src1138/VMFB-MC/motioneyeos_scripts/RPi_ZeroW_Pinout.png

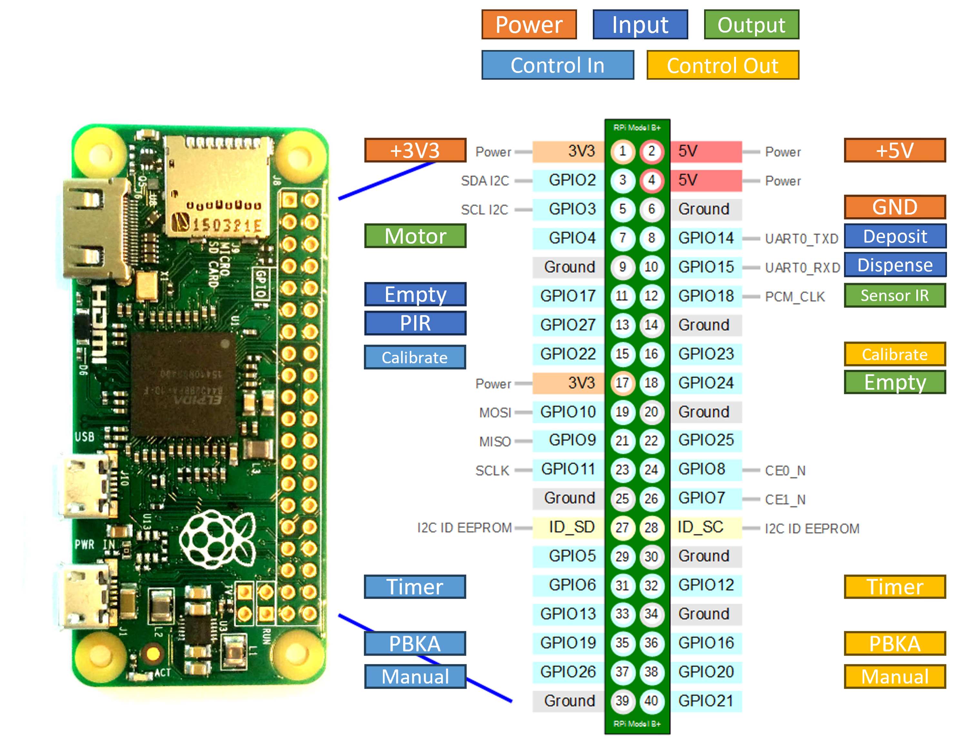
motioneyeos_scripts/RPi_ZeroW_Pinout.png
