src1138/VMFB-MC/README.md

# VMFB-MC
Simplified version of the VMFB (https://github.com/src1138/VMFB) PCB designed with a smaller footprint and BOM to rely on a microcontroller or single-board computer to control and monitor it.
