src1138/VMFB-MC/VMFB-MC.kicad_pcb

## KiCad design VMFB-MC.kicad_pcb (2025-01-15)

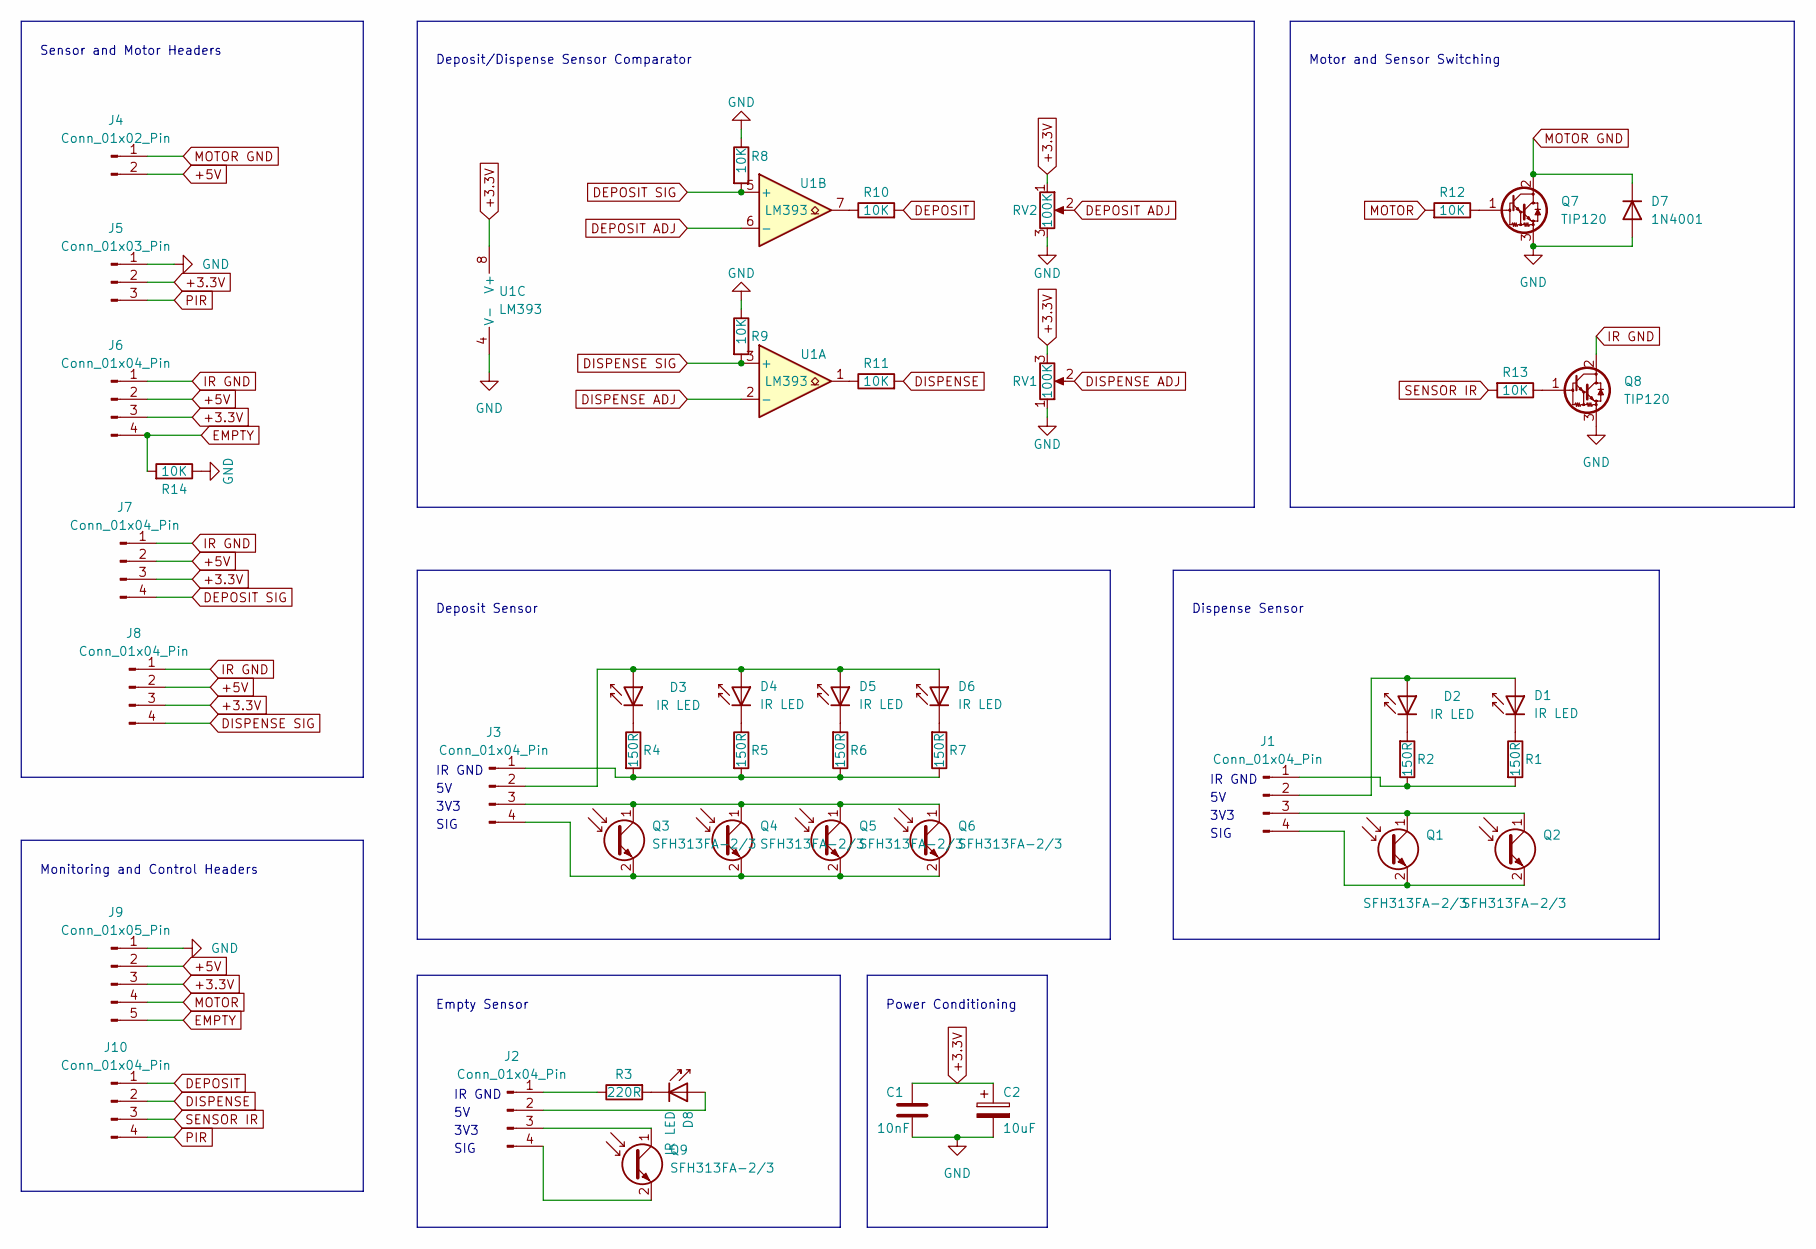
[picture p2: schematic VMFB-MC.kicad_sch, Vending Machine For Birds - Microcontroller Controlled]

Parts:
C1: 10nF; C_Disc_D5.0mm_W2.5mm_P2.50mm
C2: 10uF; CP_Radial_D5.0mm_P2.00mm
D1, D2, D3, D4, D5, D6, D8: IR LED; LED_D5.0mm_IRGrey
D7: 1N4001; D_DO-41_SOD81_P2.54mm_Vertical_KathodeUp
J1, J2, J3, J6, J7, J8, J10: Conn_01x04_Pin; PinHeader_1x04_P2.54mm_Vertical
J4: Conn_01x02_Pin; PinHeader_1x02_P2.54mm_Vertical
J5: Conn_01x03_Pin; PinHeader_1x03_P2.54mm_Vertical
J9: Conn_01x05_Pin; PinHeader_1x05_P2.54mm_Vertical
Q1, Q2, Q3, Q4, Q5, Q6, Q9: SFH313FA-2/3; LED_D5.0mm_IRBlack
Q7, Q8: TIP120; TO-220-3_Vertical
R1, R2, R4, R5, R6, R7: 150R; R_Axial_DIN0207_L6.3mm_D2.5mm_P2.54mm_Vertical
R3: 220R; R_Axial_DIN0207_L6.3mm_D2.5mm_P2.54mm_Vertical
R8, R9, R10, R11, R12, R13, R14: 10K; R_Axial_DIN0207_L6.3mm_D2.5mm_P2.54mm_Vertical
RV1, RV2: 100K; Potentiometer_Piher_PT-10-V10_Vertical
U1: LM393; DIP-8_W7.62mm

Connections:
+3.3V: C1.1, C2.1, J5.2, J6.3, J7.3, J8.3, J9.3, RV1.3, RV2.1, U1.8 (V+)
+5V: J4.2, J6.2, J7.2, J8.2, J9.2
DEPOSIT: J10.1, R10.2
DEPOSIT ADJ: RV2.2, U1.6 (-)
DEPOSIT SIG: J7.4, R8.2, U1.5 (+)
DISPENSE: J10.2, R11.2
DISPENSE ADJ: RV1.2, U1.2 (-)
DISPENSE SIG: J8.4, R9.2, U1.3 (+)
EMPTY: J6.4, J9.5, R14.2
GND: C1.2, C2.2, D7.2 (A), J5.1, J9.1, Q7.3 (E), Q8.3 (E), R8.1, R9.1, R14.1, RV1.1, RV2.3, U1.4 (V-)
IR GND: J6.1, J7.1, J8.1, Q8.2 (C)
MOTOR: J9.4, R12.2
MOTOR GND: D7.1 (K), J4.1, Q7.2 (C)
unnamed: D1.2 (A), D2.2 (A), J1.2
unnamed: D1.1 (K), R1.1
unnamed: D2.1 (K), R2.2
unnamed: D3.2 (A), D4.2 (A), D5.2 (A), D6.2 (A), J3.2
unnamed: D3.1 (K), R4.1
unnamed: D4.1 (K), R5.1
unnamed: D5.1 (K), R6.2
unnamed: D6.1 (K), R7.2
unnamed: D8.2 (A), J2.2
unnamed: D8.1 (K), R3.2
unnamed: J1.1, R1.2, R2.1
unnamed: J1.3, Q1.1 (C), Q2.1 (C)
unnamed: J1.4, Q1.2 (E), Q2.2 (E)
unnamed: J2.1, R3.1
unnamed: J2.3, Q9.1 (C)
unnamed: J2.4, Q9.2 (E)
unnamed: J3.1, R4.2, R5.2, R6.1, R7.1
unnamed: J3.3, Q3.1 (C), Q4.1 (C), Q5.1 (C), Q6.1 (C)
unnamed: J3.4, Q3.2 (E), Q4.2 (E), Q5.2 (E), Q6.2 (E)
unnamed: Q7.1 (B), R12.1
unnamed: Q8.1 (B), R13.1
unnamed: R10.1, U1.7
unnamed: R11.1, U1.1
PIR: J5.3, J10.4
SENSOR IR: J10.3, R13.2

Notes on the sheet:
Sensor and Motor Headers
IR GND
Monitoring and Control Headers
3V3
Motor and Sensor Switching
SIG
Deposit Sensor
Dispense Sensor
Empty Sensor
Power Conditioning
Deposit/Dispense Sensor Comparator

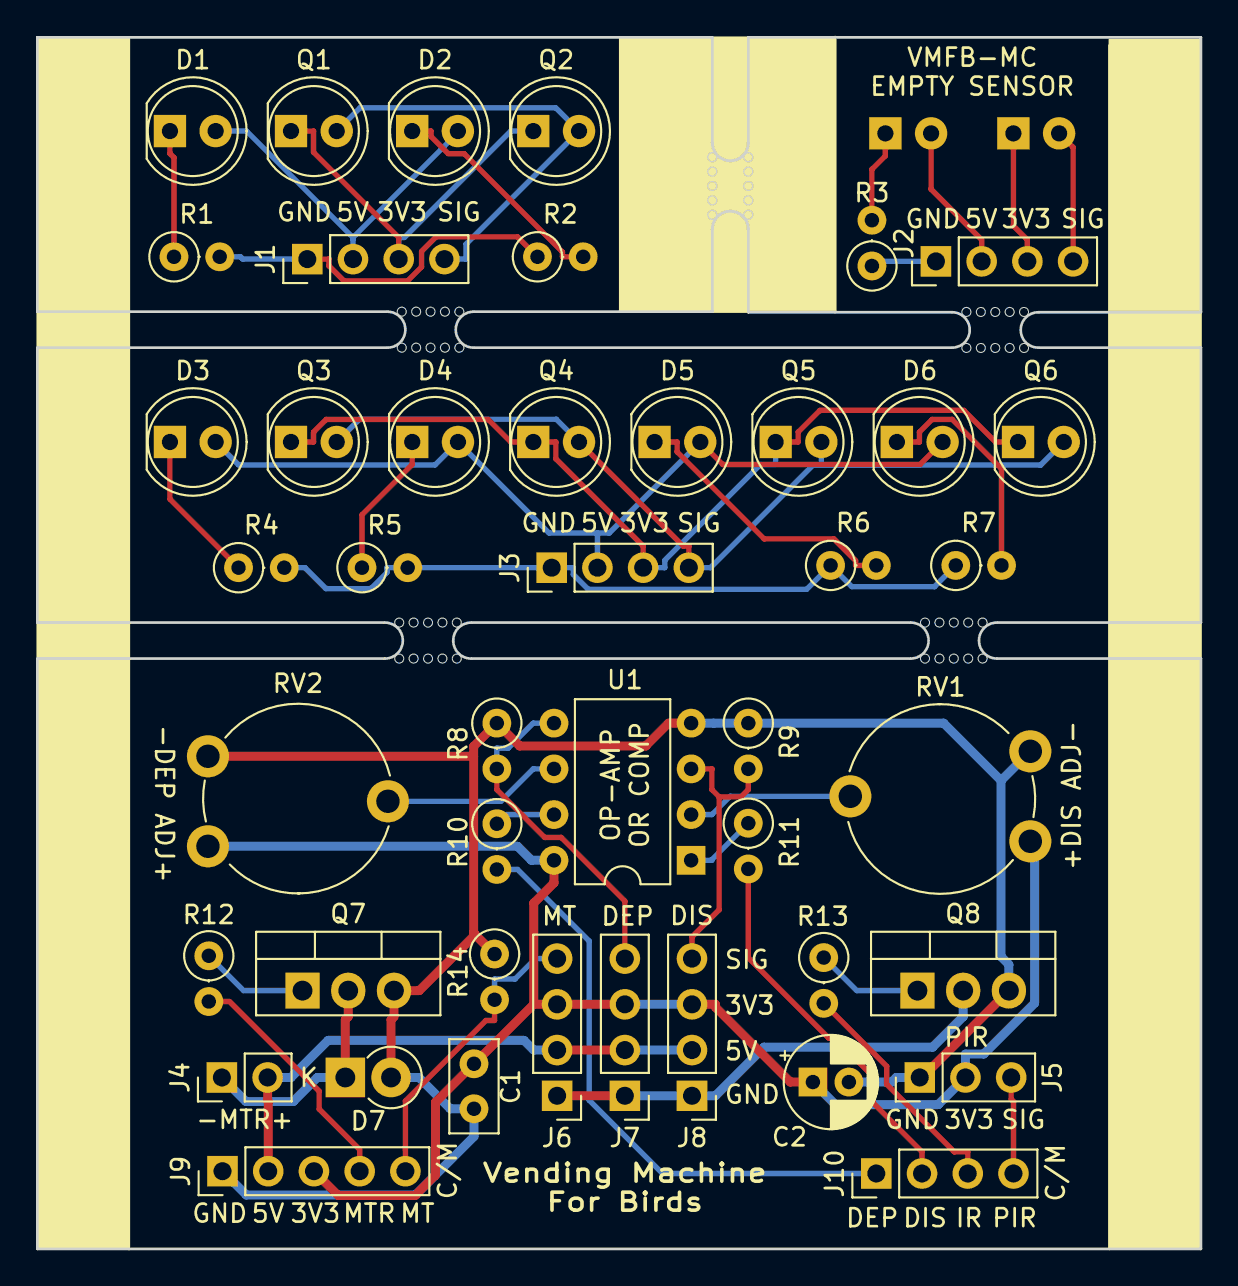
[picture p3: board VMFB-MC.kicad_pcb from above]

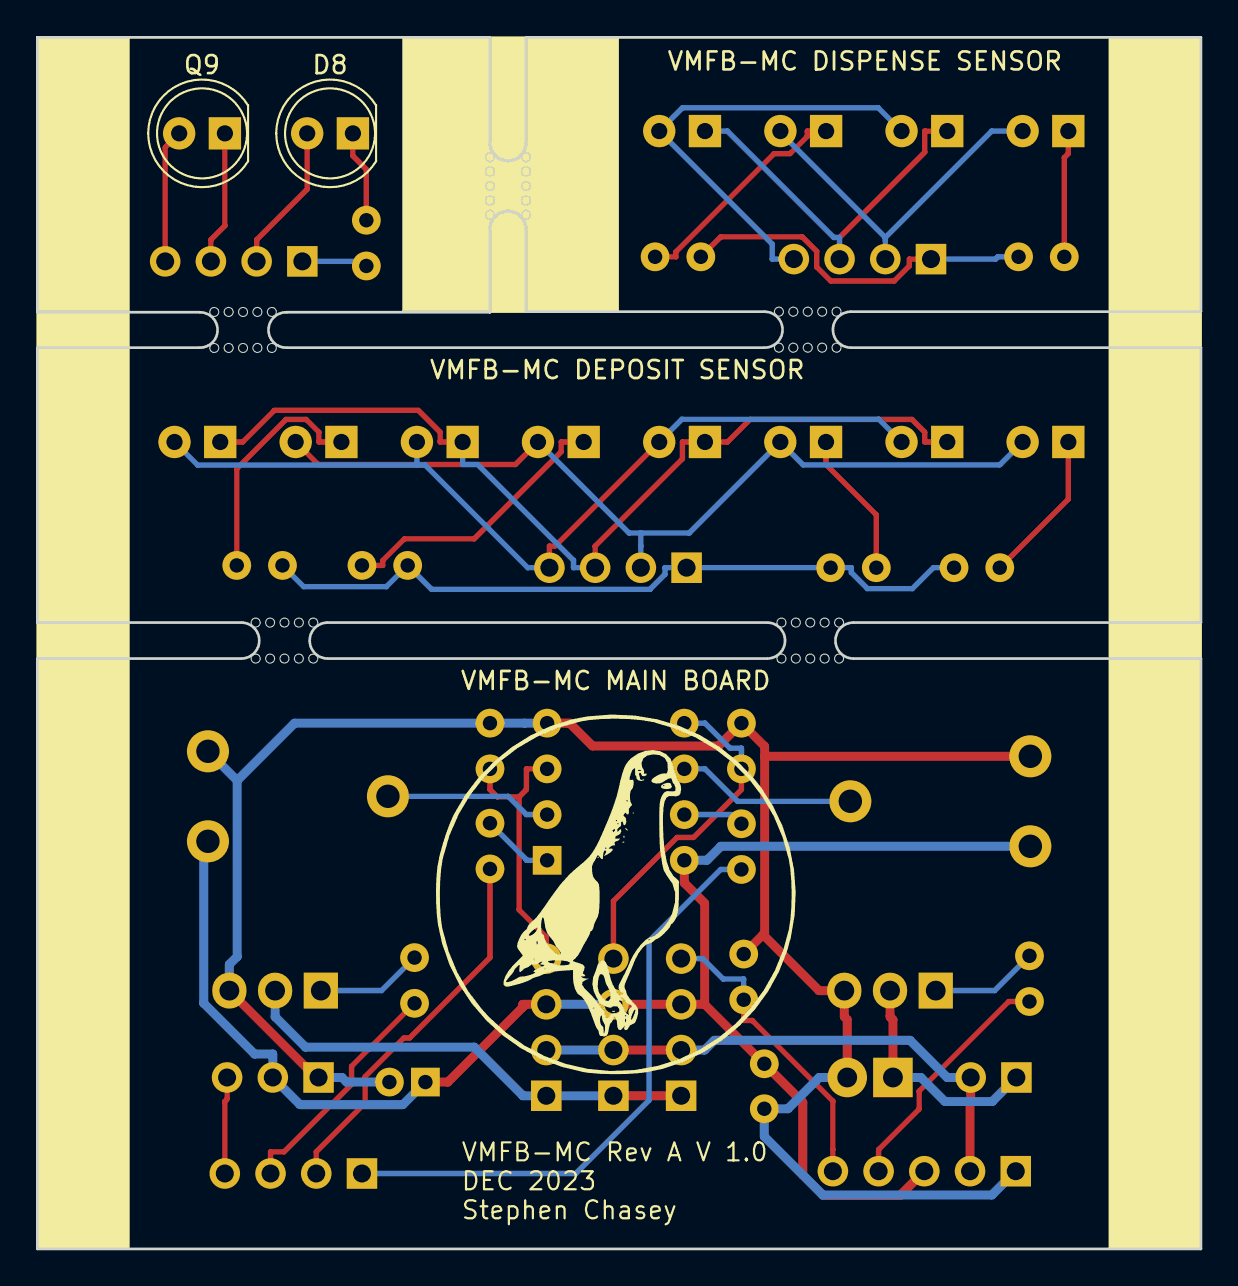
[picture p4: board VMFB-MC.kicad_pcb from below]

Board: 2 copper layers, 64.6 x 67.3 mm, 46 parts (2 on the bottom side), 38 nets.
