src1138/VMFB-MC/(commit log)

2023-11-21 Initial commit
    Basic circuit complete and layout in progress.
    [VMFB_MCU.kicad_pcb, VMFB_MCU.kicad_sch]
2023-11-21 Delete VMFB_MCU.kicad_sch
    Renaming...
    [VMFB_MCU.kicad_sch]
2023-11-21 Delete VMFB_MCU.kicad_pro
    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
2023-11-21 Delete VMFB_MCU.kicad_prl
    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
2023-11-21 Delete VMFB_MCU.kicad_pcb
    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
    [VMFB_MCU.kicad_pcb]
2023-11-21 Renamed files to match repo
    [VMFB-MC.kicad_pcb, VMFB-MC.kicad_sch]
2023-12-05 New layour and routing
    [VMFB-MC.kicad_pcb, VMFB-MC.kicad_sch]
2023-12-07 updating netclasses, adding routing
    [VMFB-MC.kicad_pcb, VMFB-MC.kicad_sch]
2023-12-07 cleaned up tracks
    [VMFB-MC.kicad_pcb]
2023-12-11 layout update
    updates layout to compress it a bit.
    [VMFB-MC.kicad_pcb, VMFB-MC.kicad_sch]
2023-12-11 Layout tweaks
    more layout and labelling tweaks
    [VMFB-MC.kicad_pcb, VMFB-MC.kicad_sch]
2023-12-12 silkscreen and label tweaks
    [VMFB-MC.kicad_pcb, VMFB-MC.kicad_sch]
2023-12-12 updated title
    [VMFB-MC.kicad_pcb, VMFB-MC.kicad_sch]
2023-12-12 cleanup schematic
    [VMFB-MC.kicad_sch]
2023-12-12 minor tweaks
    [VMFB-MC.kicad_pcb]
2023-12-13 removed 10R motor resistor and extra power header, revised placement
    [VMFB-MC.kicad_pcb, VMFB-MC.kicad_sch]
2023-12-13 more placement tweaks
    [VMFB-MC.kicad_pcb]
2023-12-18 removed power bank keep alive - can just turn on the sensors to sink curent if needed, revised layout to accomodate this
    [VMFB-MC.kicad_pcb, VMFB-MC.kicad_sch]
2023-12-18 added routes
    [VMFB-MC.kicad_pcb]
2023-12-18 reduced footprint
    footprint is now 65x68mm
    [VMFB-MC.kicad_pcb, VMFB-MC.kicad_sch]
2023-12-24 MT bleeder resistor
    Added bleeder resistor to the MT sensor.
    [VMFB-MC.kicad_pcb, VMFB-MC.kicad_sch]
2023-12-24 Cleaned up tracks placement on MT sensor
    [VMFB-MC.kicad_pcb]
2023-12-24 Cleaned up BOM naming
    [VMFB-MC.kicad_pcb, VMFB-MC.kicad_sch]
2023-12-25 clean up
    removed some unnecessary components and revised component placement.
    [VMFB-MC.kicad_pcb, VMFB-MC.kicad_sch]
2023-12-25 net clean up
    [VMFB-MC.kicad_sch]
2023-12-25 more clean up
    [VMFB-MC.kicad_pcb, VMFB-MC.kicad_sch]
2023-12-25 removed stray silkscreen label
    [VMFB-MC.kicad_pcb]
2023-12-26 more cleanup
    [VMFB-MC.kicad_pcb]
2023-12-26 even more cleanup
    [VMFB-MC.kicad_pcb]
2023-12-26 better schematic labelling
    [VMFB-MC.kicad_sch]
2023-12-27 schematic labelling
    [VMFB-MC.kicad_sch]
2024-01-08 a little more progress on motioneye scripts - still not ready
    [config.txt]
2024-01-19 Action buttons and Timer tweaks
2024-01-22 Comment and pin assignment corrections
    [config.txt]
2024-01-22 More pin assignment corrections and pinout image
    [config.txt]
2024-01-22 more pin assignment comments/corrections
2024-01-22 more pin comments/corrections
2024-01-24 Removing PBKA buttons
    This is not something you will be turning on and off often.
2024-02-06 refactored and consolidated most logic to python
    [config.txt]
2024-02-18 logging and monitoring fixes
    [VMFB-MC.py]
2024-02-19 bug fixes - still more work to do
    [VMFB-MC.py]
2024-02-21 added comment about interrupt bouncetime
2024-02-23 Fixed initial false positives on dispense sensor
    Moved adding DEP and DIS interrupts to the end of the sensorsOn routine and remove them in sensorsOff.
    This way, sensors can only trigger when the IR LEDs are on, and the short delay in enabling the interrupts avoids the initial blip you can get from phototransistors.
    [VMFB-MC.py]
2024-03-17 Added functions to enable/disable camera to save power
    Optional calls to enable camera when the sensors are on and disable it when sensors are off. This can save power as camera modules typically take 100-300mA to run.
    When using an RPi Zero W with HDMI disabled, this brings idle current comsumption to about 75mA.
2024-03-28 Initialize the MT Sensor on startup
2024-03-29 add sleep to allow VMFB-MC.py time to set up interrupts before initializing PBKA and Timer
2024-03-29 Adding sleep to give VMFB-MC.py a chance to set up interrupts and timers before executing
2024-03-31 removed merge artifact and set timer to dispense every 60min
2024-04-02 Moved PBKA and Timer init into VMFB-MC.py
2024-04-02 fix var name typo
    [VMFB-MC.py]
2024-04-02 changed Empty Sensor LED resistor from 1K to 220R
    [VMFB-MC.kicad_pcb, VMFB-MC.kicad_sch]
2024-04-04 optimize camera disable/enable
2024-04-04 optimize deposit/dispense interrupts
2024-04-10 fixed indentation issue causing segfault
    [VMFB-MC.py]
2024-04-21 Add conditional to handle dispense sensor jams
    If the dispense sensor is triggering when a deposit is sensed, it will assume there is a jam and the motor won't be turned on.
    [VMFB-MC.py]
2024-04-21 Added comments about deposit/dispense interrupts
2024-04-24 Refactoring code a bit - still having issues with resource usage
    [VMFB-MC.py]
2024-04-24 replaced tab indentation with spaces (4 per level)
    [VMFB-MC.py]
2024-04-24 cleanup thread status checking statements
2024-04-24 cleaned up file handling in camera enable/disable
2024-04-24 fix bad syntax on file handling
    [VMFB-MC.py]
2024-04-25 reference PIR pin value by variable instead of literal
2024-04-26 removed global decs in functions for timers
2024-04-29 added debugging print statements, fixed some comments - appears to be working again
    [VMFB-MC.py]
2024-05-20 Adding calibration mode
2024-05-21 Change pin assignments
    [config.txt]
2024-05-22 finish gpio pin reassignment
    [config.txt]
2024-05-22 fix calibration script name
2024-05-22 fix typo in calibration action button script
2024-05-23 turn off motor when entering calibration mode
2024-05-23 fix typo in MT pin assignment
    [VMFB-MC.py]
2024-05-23 only check PIR status when turning off sensors due to timout
2024-05-23 debugging calibration mode - PIR and sensors are not registered in the interface
2024-05-23 debugging calibration mode
2024-07-26 Fixed email thread mistake and moved email logging to end of function
    [VMFB-MC.py]
2024-08-14 Added email alerts, clean up
    Added email alerts for dispense timeout and empty/not empty state change.
    Removed commented out urllib2 import since this is no longer being used.
    [VMFB-MC.py]
2024-08-14 Add email alert for startup
    will help detect when the system reboots
    [VMFB-MC.py]
2024-08-14 declare timers as global in functions
    not declaring as global caused failure to end timer threads before they run out.
    [VMFB-MC.py]
2025-01-13 Added caps to the 3.3V rail
    [VMFB-MC.kicad_pcb, VMFB-MC.kicad_sch]
2025-01-15 Minor tweak to PCB
    [VMFB-MC.kicad_pcb]
2026-03-13 Update README_motioneye.md
    added info on calibration mode button
2026-10-25 adding manual upload action button
